orivolb/Digital-Code-Lock-System/Digital_Safe_Presentation.pdf

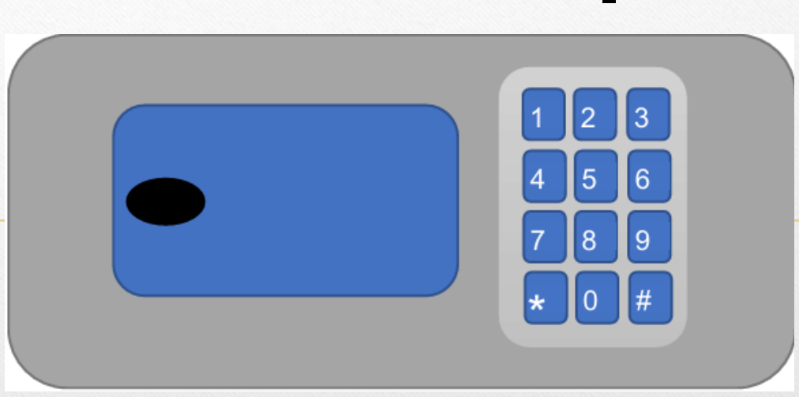
[picture p1: figure]
כספת

מנגנון דיגיטלי לאבטחת

:מציגים
אורי וולברשטיין
עקיבא בדולח

:מנחים
מר יהודה אזולאי
מר יאיר חיון

- מערכת :1 לחצני המערכת
- מערכת :2 קוד נכון
- מערכת :3 פעולת קוד נכון
- מערכת 4 קוד שגוי | : , 3 פעמים
קוד שגוי
- מערכת :5 איפוסי המערכות

חלקי
:המערכת

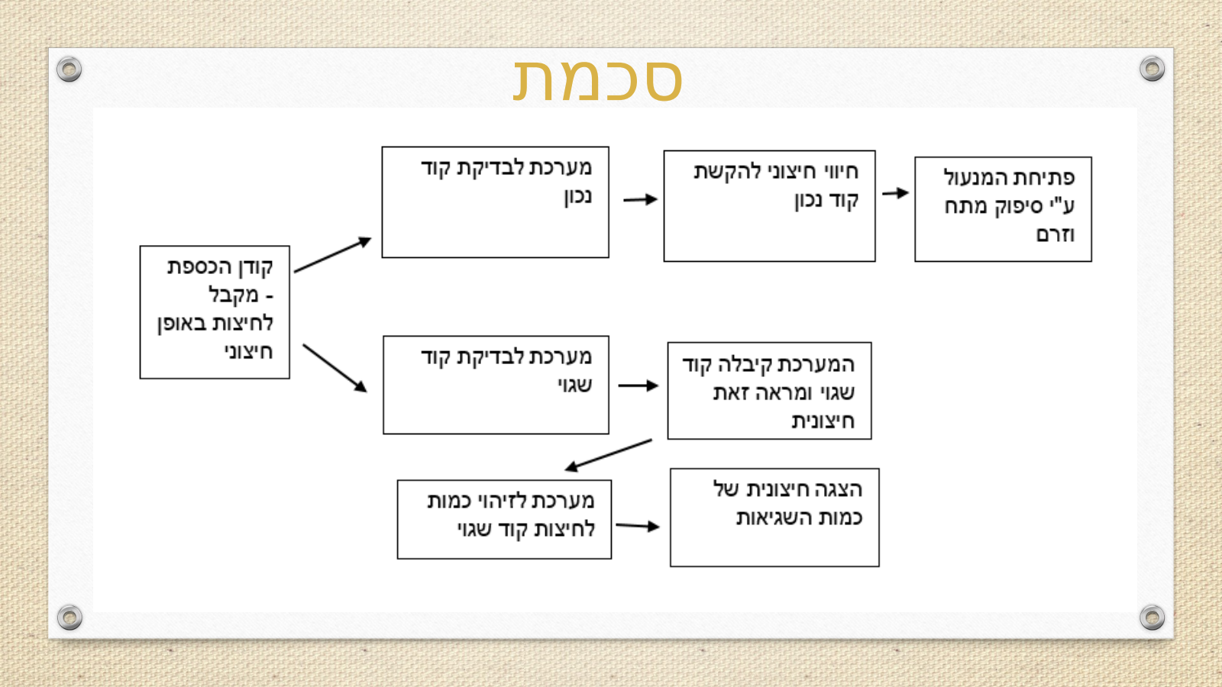
[picture p2: page 3]

סכמת
בלוקים

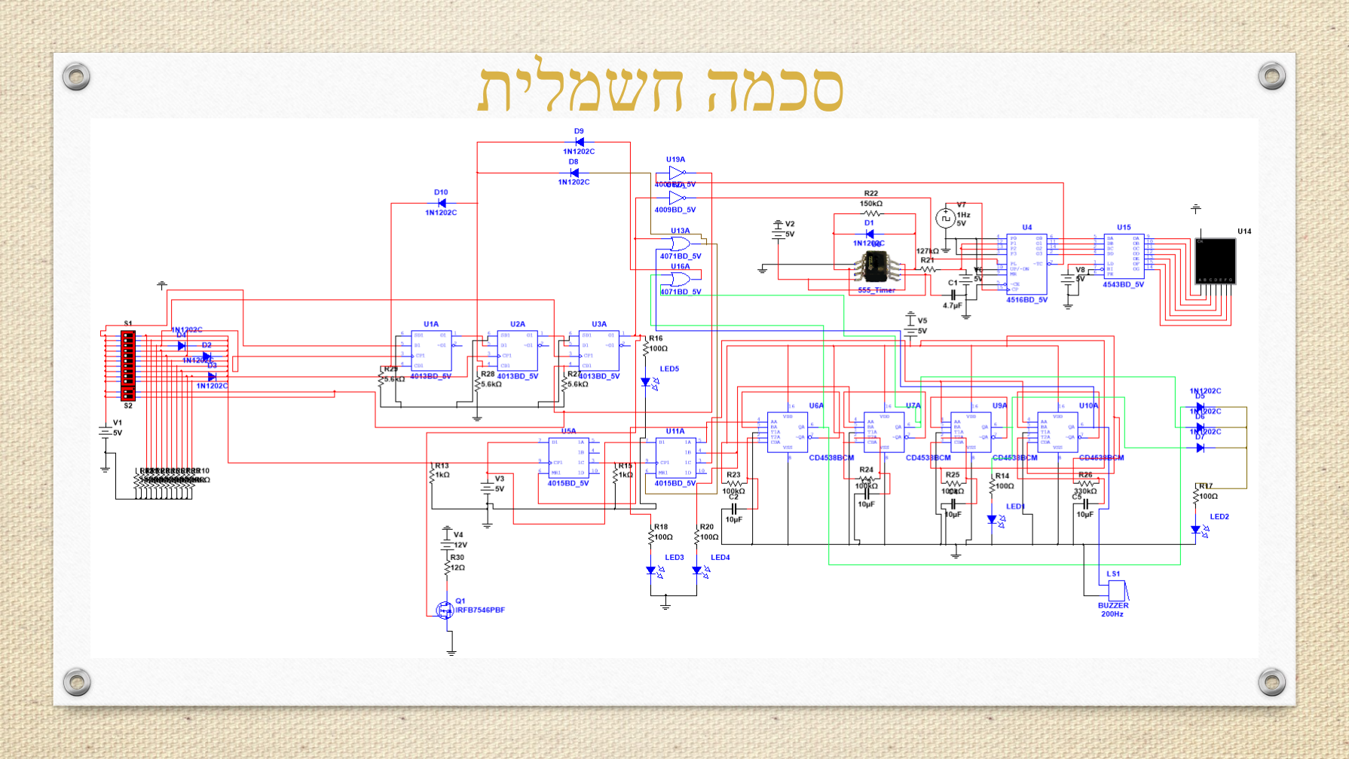
[picture p3: page 4]

סכמה חשמלית

### מערכת 1 לחצני – המערכת

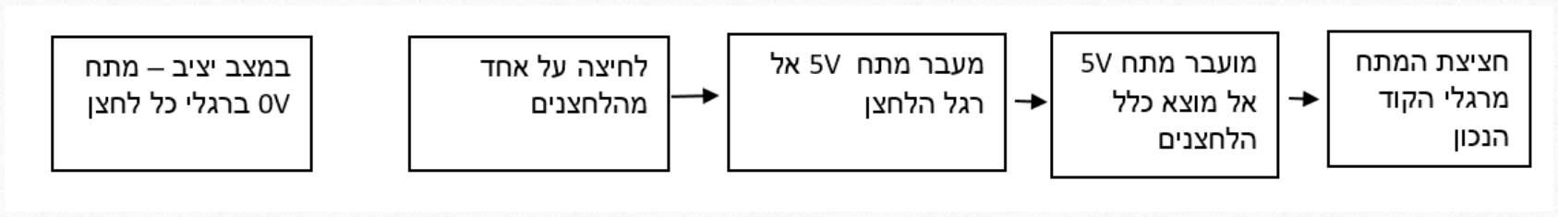
[picture p4: figure]
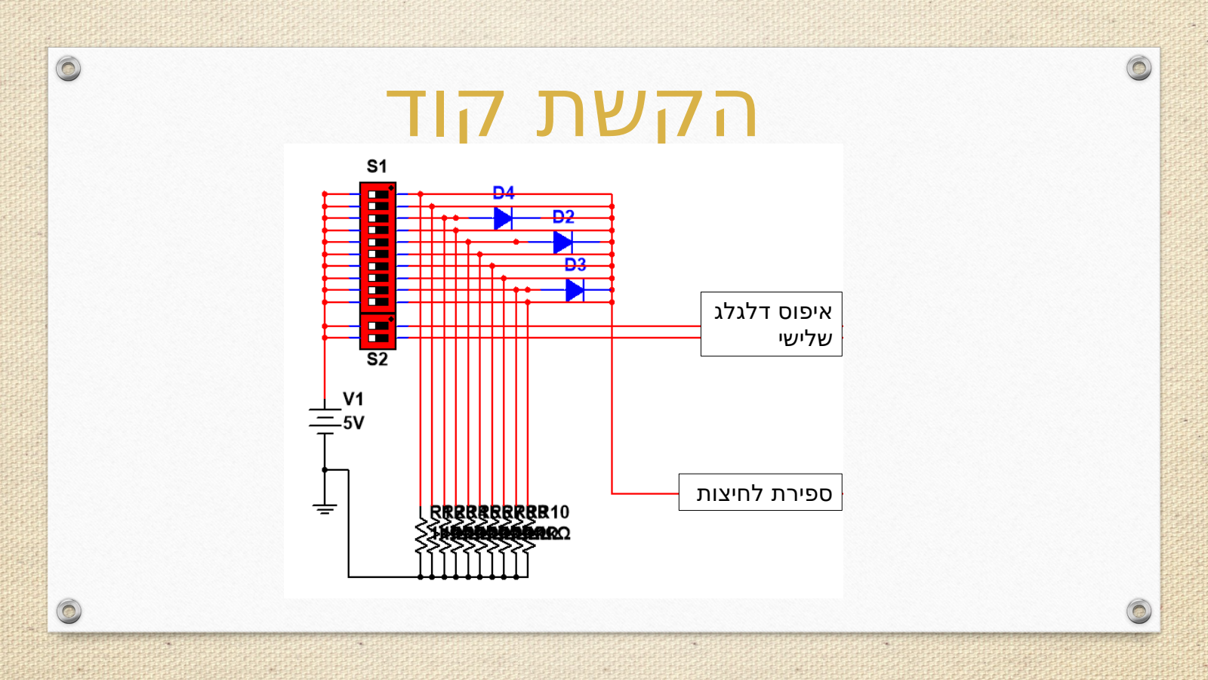
[picture p5: page 6]

### הקשת קוד

איפוס דלגלג
שלישי

ספירת לחיצות

מערכת 2 קוד –
נכון

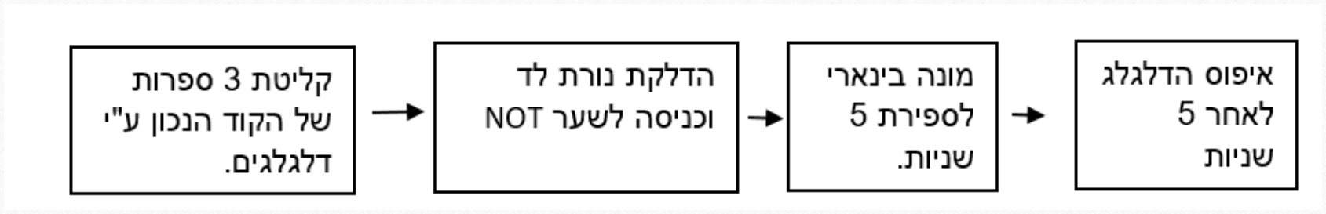
[picture p6: figure]
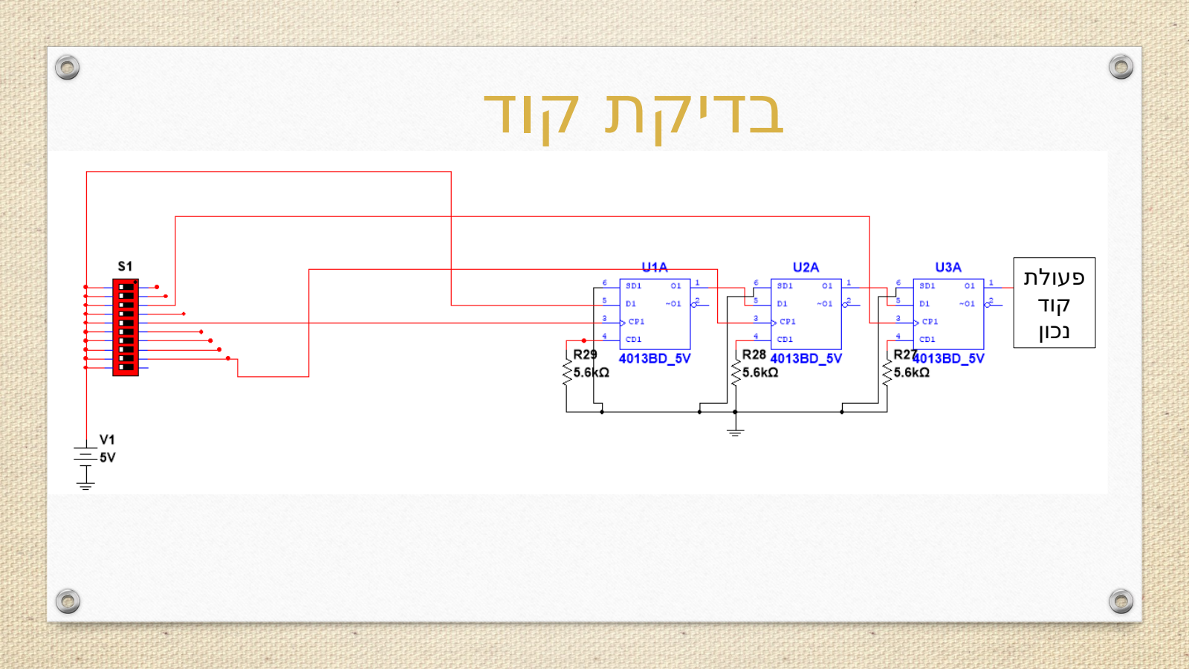
[picture p7: page 8]

בדיקת קוד
נכון

פעולת
קוד
נכון

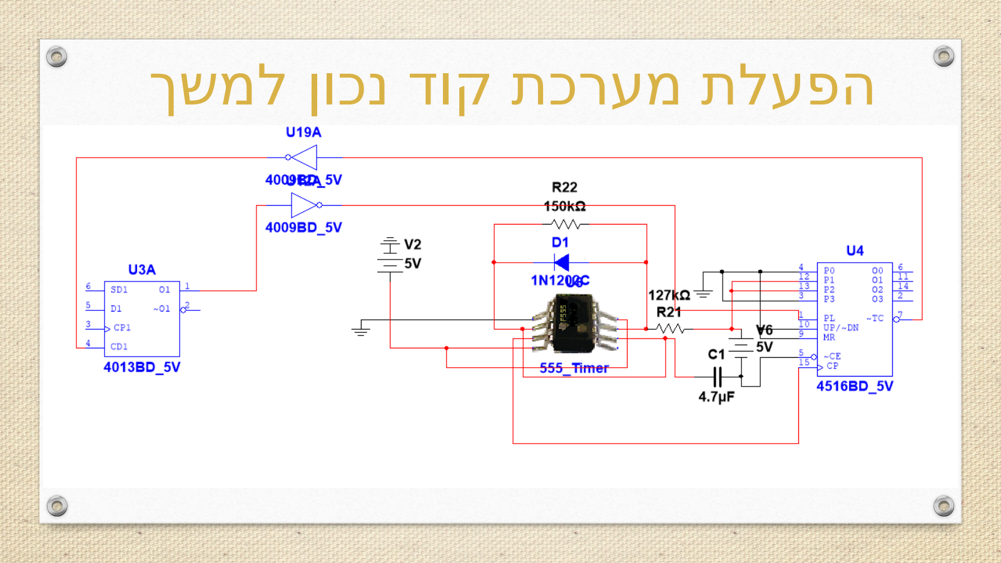
[picture p8: page 9]

הפעלת מערכת קוד נכון למשך
5 שניות

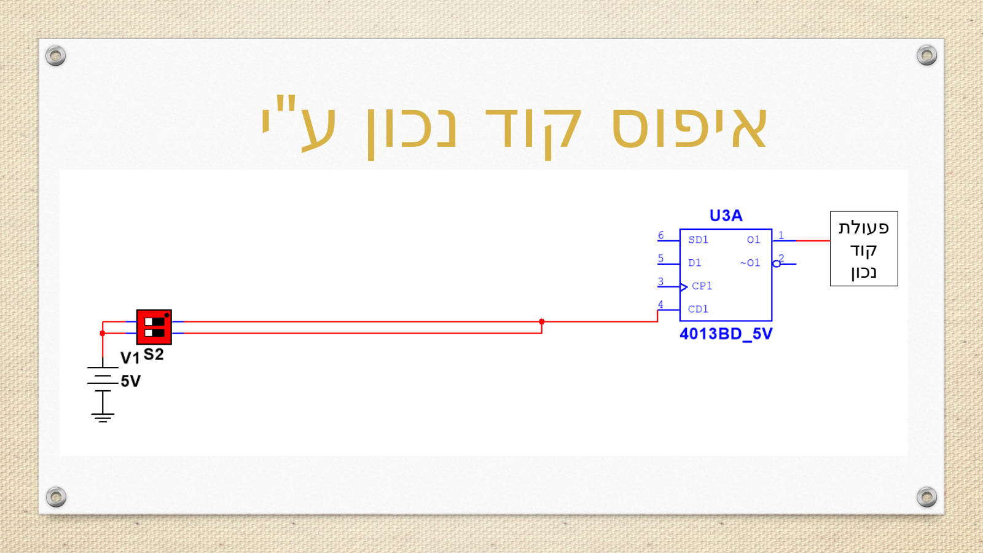
[picture p9: page 10]

" | איפוס קוד נכון ע י

פעולת # / *

קוד
נכון

מערכת 3 פעולת -
קוד נכון

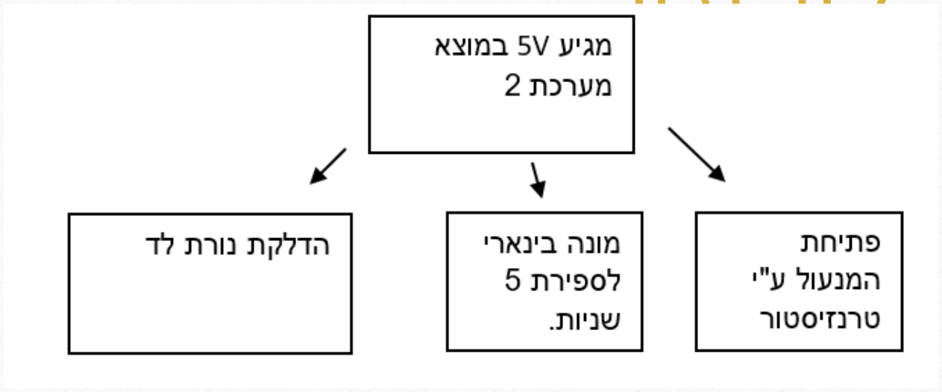
[picture p10: figure]

נורת לד נדלקת למשך 5
שניות

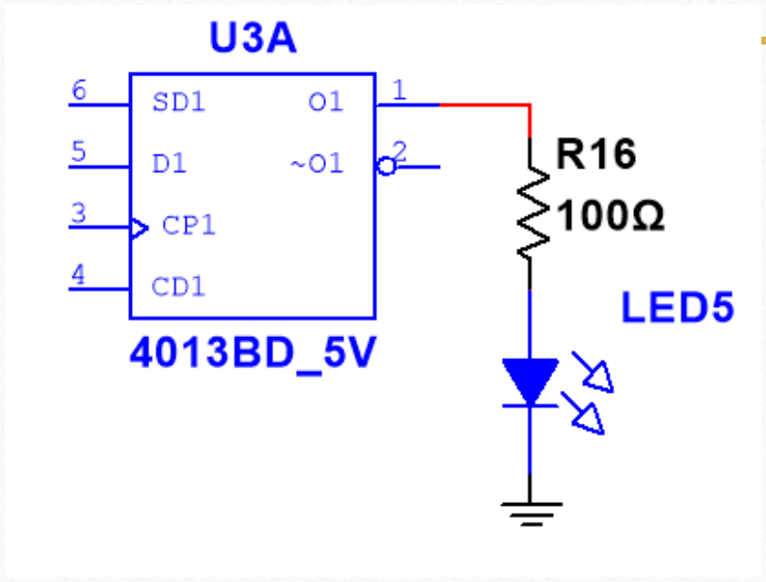
[picture p11: figure]
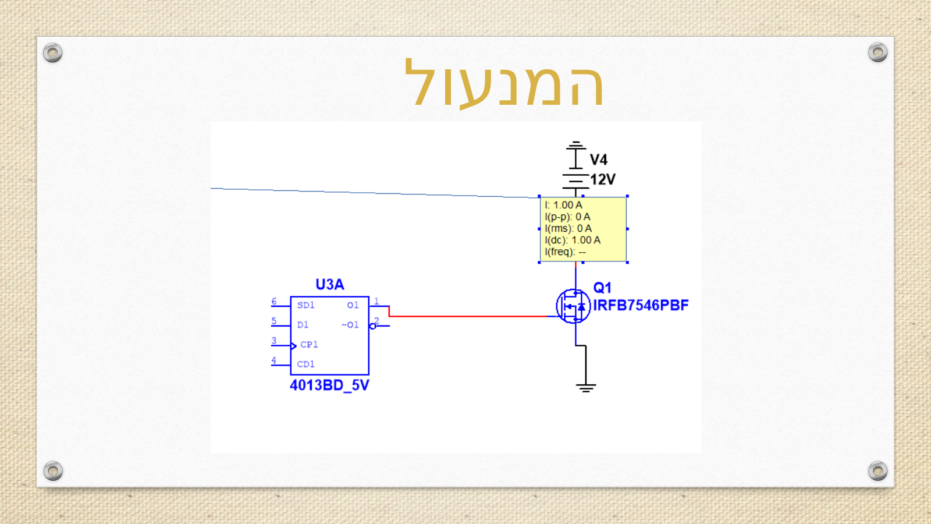
[picture p12: page 13]

### המנעול נפתח

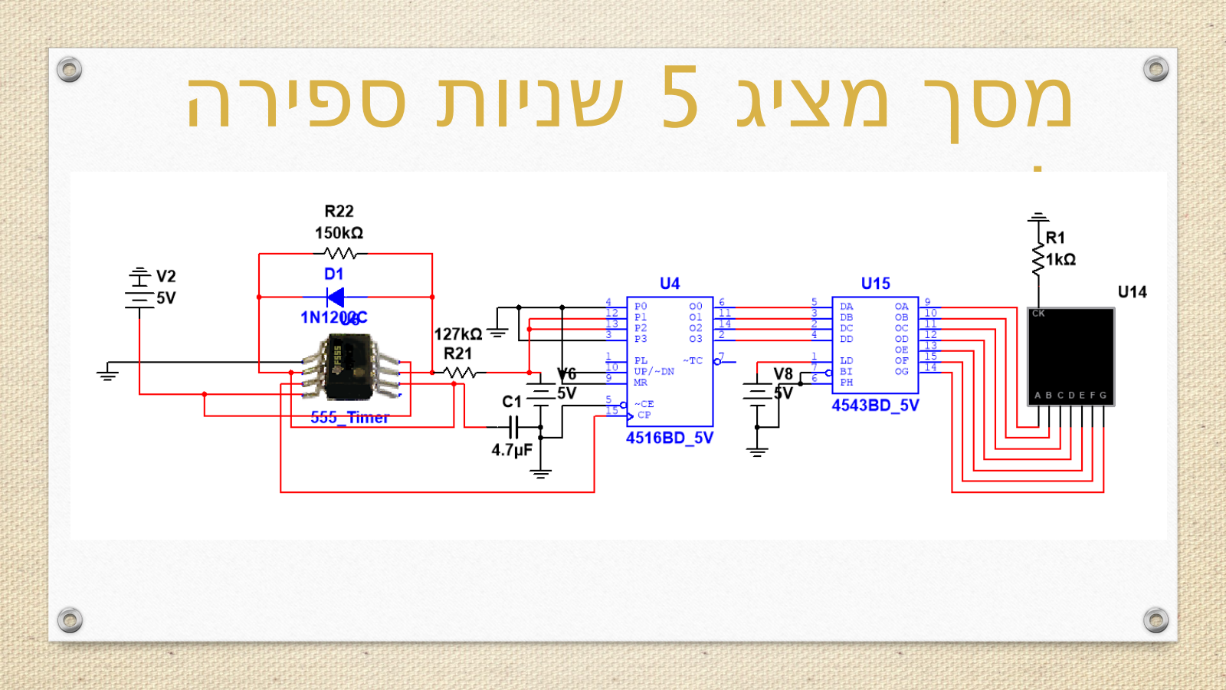
[picture p13: page 14]

### מסך מציג 5 שניות ספירה לאחור

מערכת 4 קוד שגוי | – , 3 פעמים
קוד שגוי

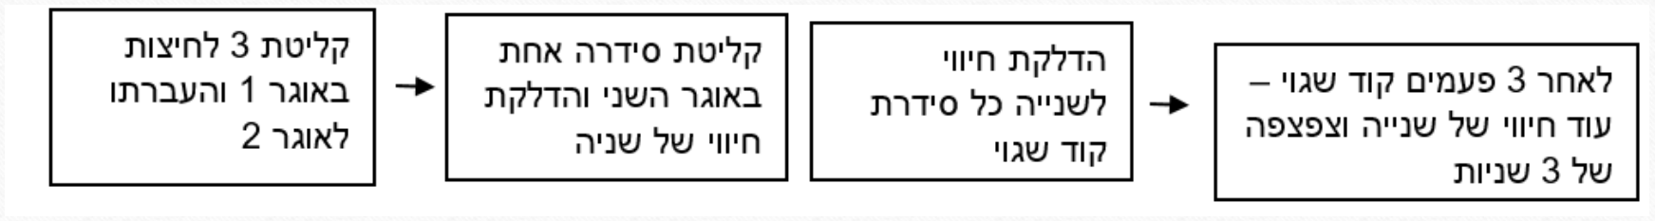
[picture p14: figure]
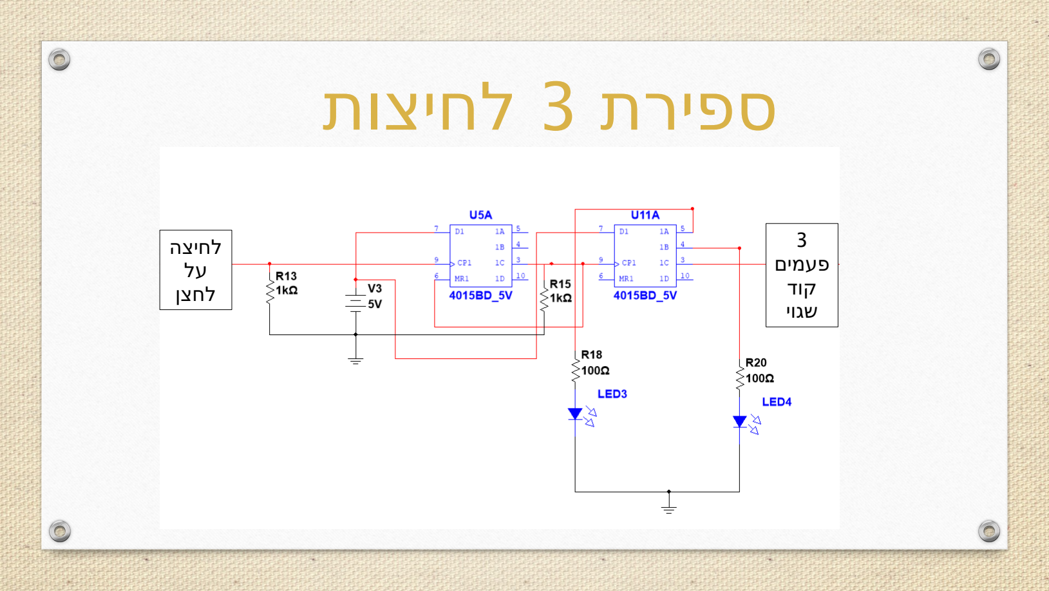
[picture p15: page 16]

ספירת 3 לחיצות

לחיצה
על
לחצן

3
פעמים
קוד
שגוי

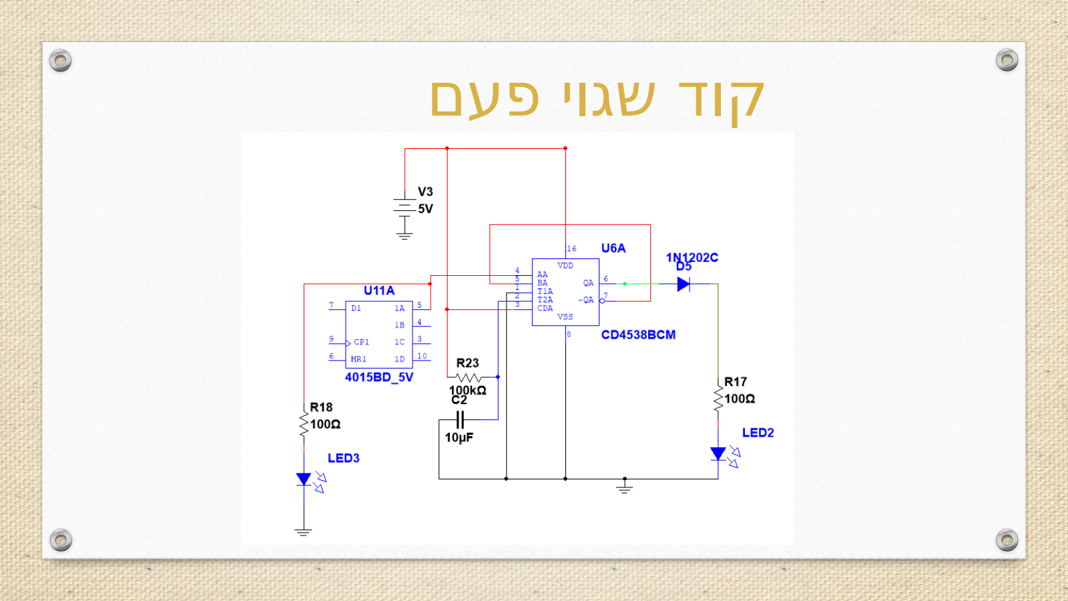
[picture p16: page 17]

קוד שגוי פעם
ראשונה

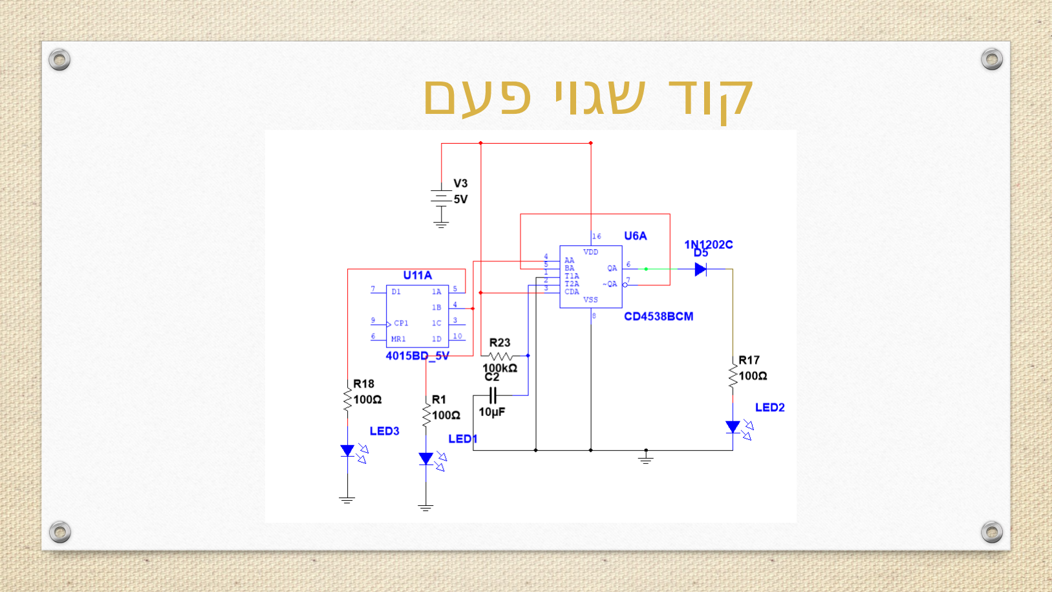
[picture p17: page 18]

קוד שגוי פעם
שנייה

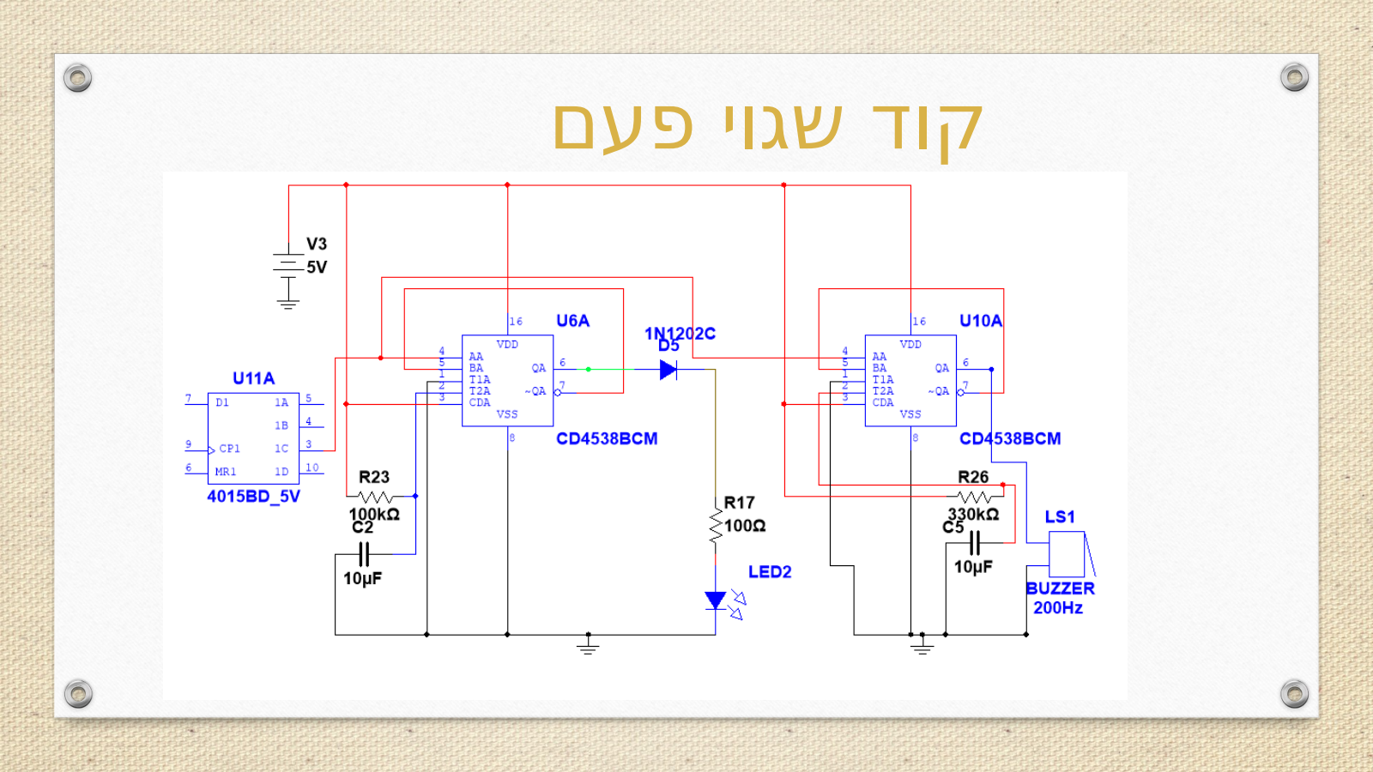
[picture p18: page 19]

קוד שגוי פעם
שלישית

מערכת 5 איפוסי –
המערכות

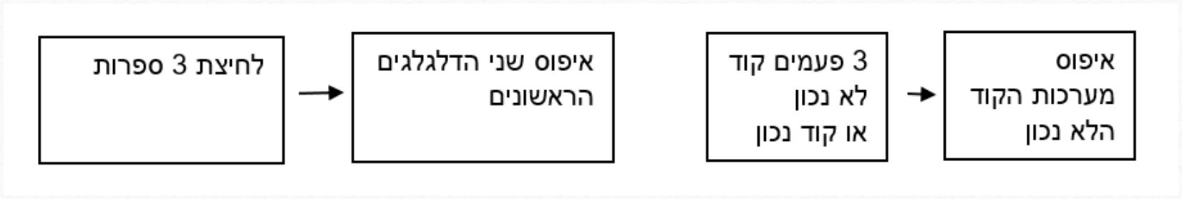
[picture p19: figure]
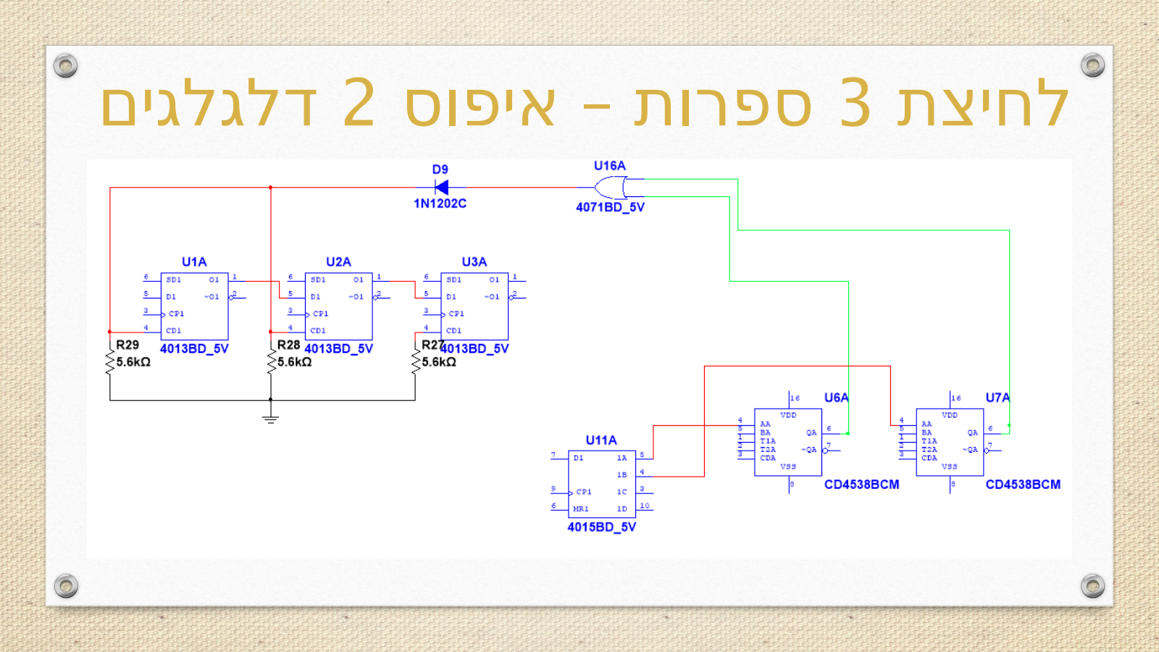
[picture p20: page 21]

לחיצת 3 ספרות איפוס – 2 דלגלגים ראשונים

3 פעמים קוד שגוי קוד /
נכון –

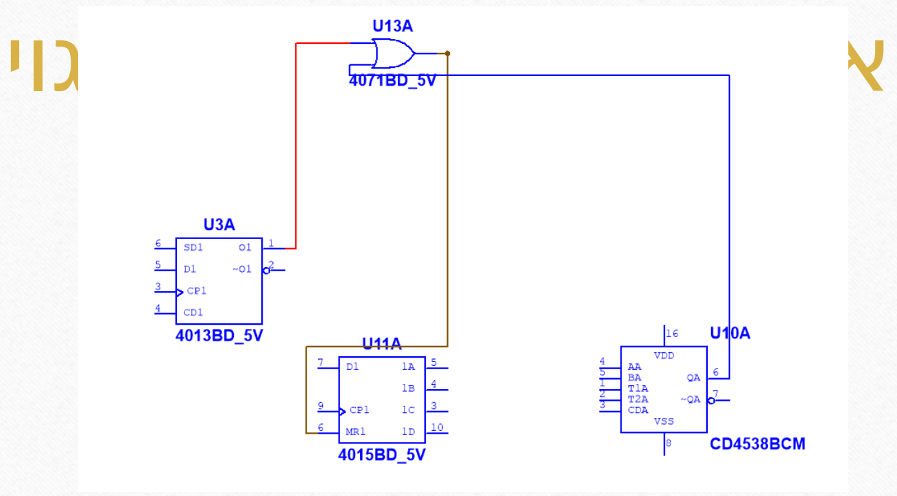
[picture p21: figure]
איפוס מערכת קוד שגוי

## התוצר הסופי

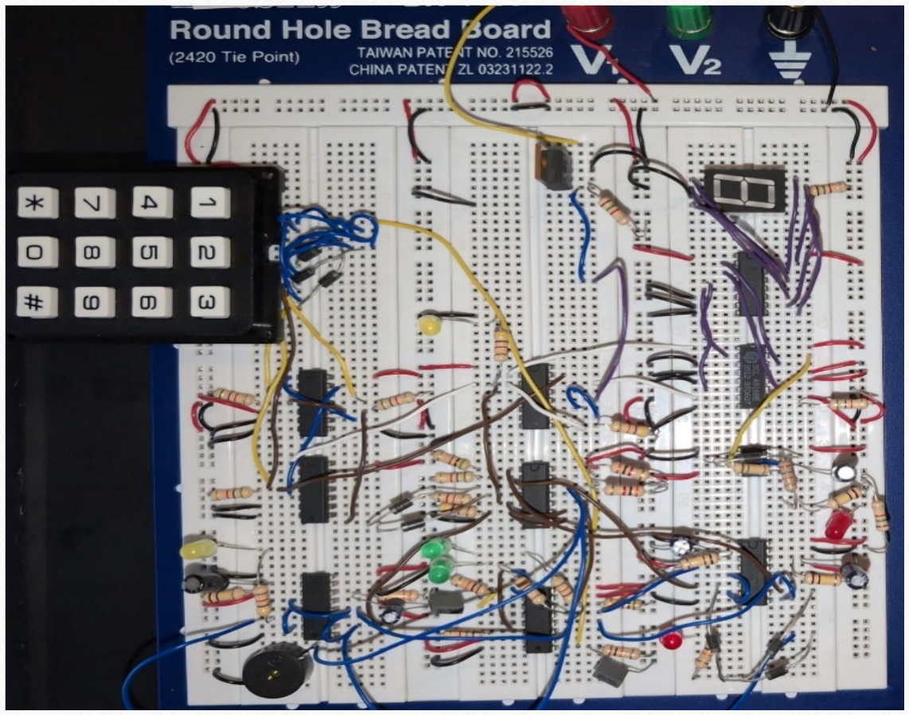
[picture p22: figure]

! תודה רבה על ההקשבה
בהזדמנות זו נשמח
להודות
למדריכים המסורים
יהודה ויאיר על הליווי
וההדרכה
