orivolb/Digital-Code-Lock-System/(list of files, drawings)

Other design files:
Safe_Circuit_Schematic.ms14
