orivolb/Digital-Code-Lock-System/(commit log)

2026-05-14 Rename מצגת כספת דיגיטלית.pdf to Digital_Safe_Presentation.pdf
2026-05-14 Rename ספר פרויקט כספת דיגיטלית.pdf to Digital_Safe_Project_Book.pdf
